Varas10/Alimentation-Photovoltaique/Rapport par fonction/Document de MAINTENANCE.md

# 1. Introduction

Ce document décrit les procédures de maintenance pour le système d'alimentation photovoltaïque développé dans le cadre du projet. Il vise à assurer le bon fonctionnement du système sur le long terme en proposant des recommandations d'entretien, des procédures de diagnostic et des solutions aux problèmes courants.

# 2. Description du système

Le système est conçu pour convertir l'énergie solaire en électricité utilisable. Il comprend :

- Un panneau photovoltaïque (PV) pour la capture de l’énergie solaire.
    
- Un convertisseur pour adapter la tension.
    
- Un système de stockage (batteries).
    
- Un circuit de régulation et de protection.
    
- Un dispositif de mesure et de contrôle.

# 3. Procédures de maintenance

### 3.1. Inspection régulière

- Vérifier visuellement l’état du panneau PV (absence de fissures, propreté).
    
- Examiner les connexions électriques (absence d’oxydation, solidité des connexions).
    
- Contrôler l’état des câbles et des connecteurs (usure, détérioration).
    
- Vérifier l’état des batteries (tension correcte, absence de fuites).
    
- Inspecter le convertisseur et les régulateurs de tension (échauffement anormal, composants endommagés).

### 3.2. Nettoyage

- Nettoyer les panneaux PV avec un chiffon humide non abrasif pour éviter l’accumulation de poussière.
    
- Enlever les débris autour du système pour éviter toute obstruction.
    
- Dépoussiérer les composants électroniques avec un souffleur d’air sec.

### 3.3. Tests périodiques

- Mesurer la tension et le courant de sortie des panneaux PV.
    
- Vérifier les niveaux de charge des batteries.
    
- Tester le bon fonctionnement des convertisseurs et régulateurs.

# 4. Dépannage et erreurs courantes

|Problème|Cause possible|Solution|
|---|---|---|
|Faible production d’énergie|Panneau sale ou endommagé|Nettoyer ou remplacer le panneau|
|Batterie ne charge pas|Connexion lâche, batterie défectueuse|Vérifier les connexions, tester ou remplacer la batterie|
|Convertisseur chauffe anormalement|Ventilation insuffisante, surcharge|Vérifier la charge, améliorer la ventilation|
|Absence de sortie électrique|Problème de connexion, fusible grillé|Inspecter et remplacer le fusible si nécessaire|

# 5. Pièces de rechange et consommables

- Fusibles de rechange
    
- Connecteurs et câbles électriques
    
- Batteries de remplacement
    
- Produits de nettoyage pour panneaux PV

# 6. Sécurité

- Couper l’alimentation avant toute intervention sur le système.
    
- Utiliser des équipements de protection individuelle (gants isolants, lunettes de protection).
    
- Éviter d’intervenir en milieu humide ou sous la pluie.
    
- Suivre les consignes du fabricant pour la manipulation des batteries.
