Varas10/Alimentation-Photovoltaique/Rapport par fonction/Documents de MISE EN SERVICE.md

TALENT Julien & RUIZ Evan

# Matériels nécessaires
--- 
### Câbles :
- 5 câbles bananes

### Cartes :
- Cartes routée regroupant la partie commande et l'alimentation de la partie commande.
- Carte de la partie puissance.

### Multimètre

# Branchement
---
- Branchez le - du panneau photovoltaïque (PV) sur la borne PV- de la carte de commande.
- Branchez le + du PV sur la borne PV+ de la carte commande.
- Branchez le connecteur "Alim-" sur l'une des bornes M du Hacheur (partie puissance).
- Branchez le connecteur "Alim+" sur la borne F du Hacheur.
- Brancher le + du PV sur la borne A du Hacheur.
- Branchez le multimètre sur la sortie du Hacheur.

# Réglages 
---
### Tension de sortie
- Réglez la tension de sortie en tournant le potentiomètre.
- Pour alimenter un téléphone, réglez la tension de sortie du Hacheur à 5V.
- Pour alimenter une carte Altéra, réglez la tension de sortie du Hacheur à 7,5V.

#### Mise en garde
- Attention à ne pas trop dépasser le 7,5V au risque de faire chauffer les composants ainsi que le téléphone si il est branché à ce moment là.

# Bon fonctionnement du système
---

- Si la tension de sortie est adaptée à vos besoins (5V ou 7,5V) alors le montage fonctionne très bien.
