Varas10/Alimentation-Photovoltaique/Rapport par fonction/rapport perso de julien.md

Talent Julien
# Rapport final du projet d'alimentation hacheur

## 1. Introduction

L’objectif de ce projet était de concevoir une alimentation à découpage alimentée par un panneau photovoltaïque (PV) de **20V - 10W**, capable de fournir :

- **5V - 1A** pour un téléphone,
    
- **7,5V - 0,8A** pour une carte Altera DE1.

Pour mener à bien ce projet, nous avons utilisé **Micro-Cap** pour les simulations et **Eagle** pour le routage de la carte de commande. Une carte hacheur nous a été fournie, et nous avons conçu une carte additionnelle utilisant un **NE555** pour générer le signal de commande du hacheur.

## 2. Déroulement du projet

Le projet s'est déroulé conformément au plan initial. Nous avons adopté une approche modulaire, ce qui nous a permis d’aborder chaque étape de manière organisée :

1. **Étude du fonctionnement d’un hacheur et de la modulation PWM.**
    
2. **Simulation du circuit sous Micro-Cap** pour vérifier les performances théoriques.
    
3. **Conception et routage de la carte de commande sous Eagle.**
    
4. **Fabrication et test du circuit final** avec la carte hacheur.

## 3. Résultats et analyse

Les résultats finaux **correspondent aux attentes**. Nous avons réussi à obtenir les tensions de sortie prévues en ajustant le rapport cyclique du signal PWM. Cependant, un problème notable a été identifié :

- Le système conçu **n’est pas pratique pour un utilisateur lambda**, car il nécessite de **mesurer la tension de sortie avec un multimètre** et d’ajuster le rapport cyclique via un potentiomètre.

## 4. Bilan personnel et perspectives d’amélioration

### **Intérêt du projet**

Ce projet a été **très intéressant**, car il m’a permis de découvrir le fonctionnement d’une alimentation à découpage et de **concevoir un oscillateur**.

### **Apports techniques et personnels**

J’ai gagné en autonomie pour la réalisation de futurs projets et je me sens **plus confiant dans ma capacité à mener un projet à bien**.

### **Améliorations possibles**

Si je devais refaire ce projet, je prendrais plus de temps pour réfléchir aux **tolérances des composants** à prendre en compte.

Pour améliorer le système, il serait intéressant de :

- **Intégrer toute l’électronique sur une seule carte** pour plus de compacité.
    
- **Automatiser la régulation de la tension** afin d’éviter l’ajustement manuel.
    
- **Ajouter un interrupteur de sélection** pour choisir l’appareil à alimenter (téléphone ou carte Altera DE1) sans besoin de réglage manuel.

## 5. Conclusion

Ce projet a été une **expérience enrichissante** tant sur le plan technique que personnel. Il m’a permis de mettre en application des notions théoriques et d’améliorer ma méthodologie de travail. Avec quelques améliorations, cette alimentation pourrait être plus ergonomique et accessible à un utilisateur non expérimenté.
