Varas10/Alimentation-Photovoltaique/Rapport par fonction/F2 - Partie commande/Rapport partie commande.pdf

# Rapport partie commande

TALENT Julien et RUIZ Evan

# Rôle de la fonction :

Elle permet de choisir la tension de sortie en modulant la largeur de l'impulsion (la pwm).

# Schéma :

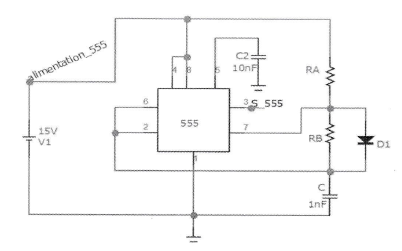
[picture p5: figure]

Sans le potentiomètre

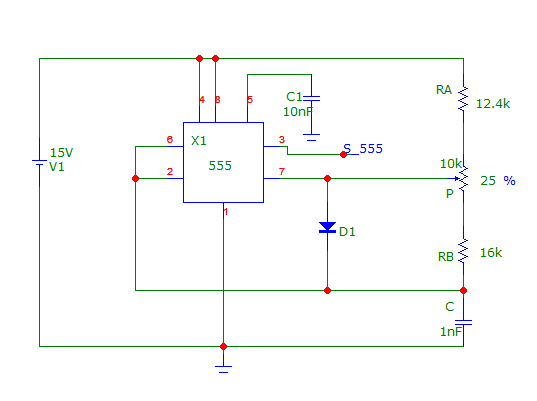
[picture p6: figure]

avec le potentiomètre

# Fonctionnement :

Grâce au potentiomètre on peut modifier la largeur des impulsion ce qui permet de modifier le rapport cyclique.

La diode fait passer le courant jusqu'au condensateur lorsqu'il est en charge.

En charge le courant passe par RA et la diode, et en décharge il passe par RB et va dans le 555

# Choix des résistances :

Afin de choisir les résistances adéquats, nous avons procédé a une série de calculs :

Appareil à alimenter avec tension panneau = Ve = 20V | Pour le téléphone (5V) : | Pour la carte altéra (7.5V) :
Tension à la sortie du hacheur : | 5V | 7.5V

Appareil à alimenter avec tension panneau = Ve = 20V | Pour le téléphone (5V) : | Pour la carte altéra (7.5V) :
rapport cyclique : α = V s V e | 15 = 25% 5 = | = 7.5 15 = 38%
période d'oscillation T = 1 f | = 40k = 25µs 1
temps à l'état hautt1 = α ∗ T | = 0.25 ∗ 25 −6 = 6.25µs | = 0.38 ∗ 25 −6 = 9.5µs
0.693∗C t1 Ra = | = 0.693∗1⁻⁹ = 9kΩ 6.25 −6 | = 9.5 −6 0.693∗1⁻⁹ = 13.7kΩ
t2 = (1 − α) ∗ T | −6 = 18.75µs = (1 − 0.25) ∗ 25 | = (1 − 0.38) ∗ 25 −6 = 15.5µs
t2 RB = 0.693∗c − P | = 27kΩ | = 22.4kΩ
RA+RB | = 36kΩ | = 36kΩ

## Simulation avec RA et RB :

| RA normalisée | Rb normalisée | rapport cyclique que l'on devrait obtenir | rapport cyclique vaec la simulation
Vs = 5V | 8.2kΩ | 27kΩ | 23% | 25%
VS = 7.5V | 15kΩ | 22kΩ | 41% | 43%

On constate que la simulation est proche du résultats que l'on attendait.

# Ajout d'un potentiomètre :

évolution de la tensions par rapport à l'ensolellement | il faut malgré tout avoir une tension en sortie du hacheur VS de : | rapport cyclique correspondant | position du potentiomètre
descend à 16V | 7.5V | maximal de 47% | basse (x=100%)
monte à 22V | 5V | minimal de 23% | haute (x=0)

## calcul de RA et Rb

On utilise la formule suivante :

RA = 6.4kΩ , valeur normalisée : 6.8kΩ RB = 17kΩ , valeur normalisée : 18kΩ

## Simulation :

pour V1=16v ou pour V1=22V, les rapports cyclique et tensions de sortie sont identique.

Position du Potentiometre | rapport cyclique prévue | rapport cyclique obtenue | fréquence d'oscillation observée
Haute(x=0) | 19.5% | 21% | 40,2kHz
Basse (x=100%) | 48% | 50% | 39,5kHz

# Mesures et chronogrammes

## Problème !

Notre coupe RA-RB nous empêchez de descendre en dessous de 26% de rapport cyclique or on souhaite définir un rapport cyclique de 20% donc on change les résistances.

On obtient

## P en position basse(Potentiomètre à 100%) :

En position basse, le rapport cyclique doit être maximal

## calculs :

RA =

αmin∗P

αmax−αmin
RB =

RA−αmin(RA+P)

αmin
obtenue à partir de la formule du rapport cyclique pour X=0 :

α =

RA
Ra+RB+P
avec

RA + RB + P = RA+P

αmax

pour X=0 et

RA + RB + P =

RA

αmin

pour x=1.

RA =4.3kΩ et RB = 14kΩ.
On utiliseras des résistances normalisées E12 : RA = 3.9kΩ et Rb = 15kΩ.

tension VC | la tension de sortie Vs est à l'état | formule (p=10k) | rapport cyclique (pratique) : | Rapport cyclique (théorie) :
monte | haut pendant 11.4µs | t1 = 0.693(RA + P)C = 9.6µs | 51% | 48%
descend | bas pendant 10.8µs | t2 = 0.693RB ∗ C = 10.3µs

## P en position haute(Potentiomètre à 0%) :

En position haute, le rapport cyclique doit être le minimum voulu :

## calculs :

tension VC | la tension de sortie Vs est à l'état | formule (p=10k) | rapport cyclique (pratique) : | Rapport cyclique (théorie) :
monte | haut pendant 44µs | t1 = 0.693(RA + P)C = 2.7µs | 19.6% | 13.5%
descend | bas pendant 16.4µs | t2 = 0.693RB ∗ C = 17.3µs

# Conclusion :

Donc nous avons assemblé la partie commande :

Grâce à la PWM, on peut adapté le rapport cyclique par rapport à nos besoins(20% - > 50%).
De plus, les résistances choisis sont calculer pour obtenir une tension de sortie adéquate. Alors on peut alimenter une carte Altera en 7.5V ou un téléphone portable en 5V.
