Varas10/Alimentation-Photovoltaique/20250318_163907.jpg

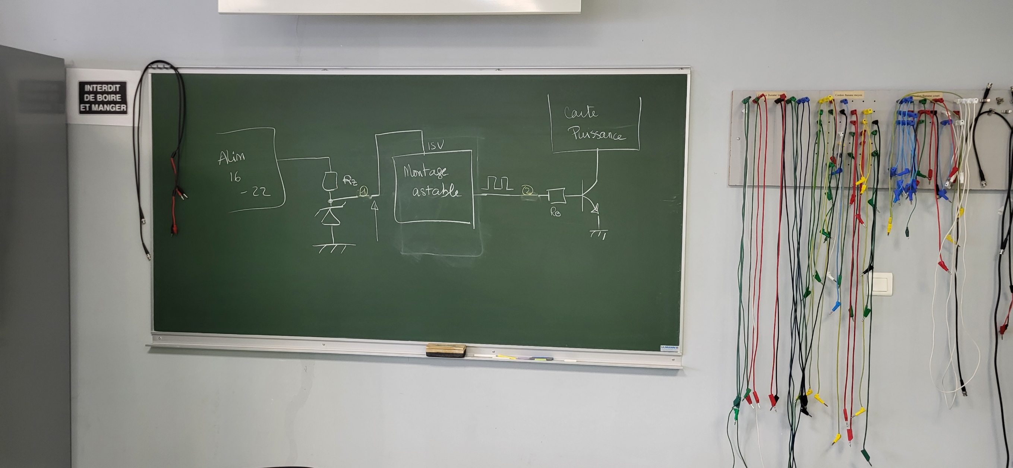
20250318_163907.jpg
