Varas10/Alimentation-Photovoltaique/Rapport par fonction/F1 - Partie puissance/Courbes hacheur.png

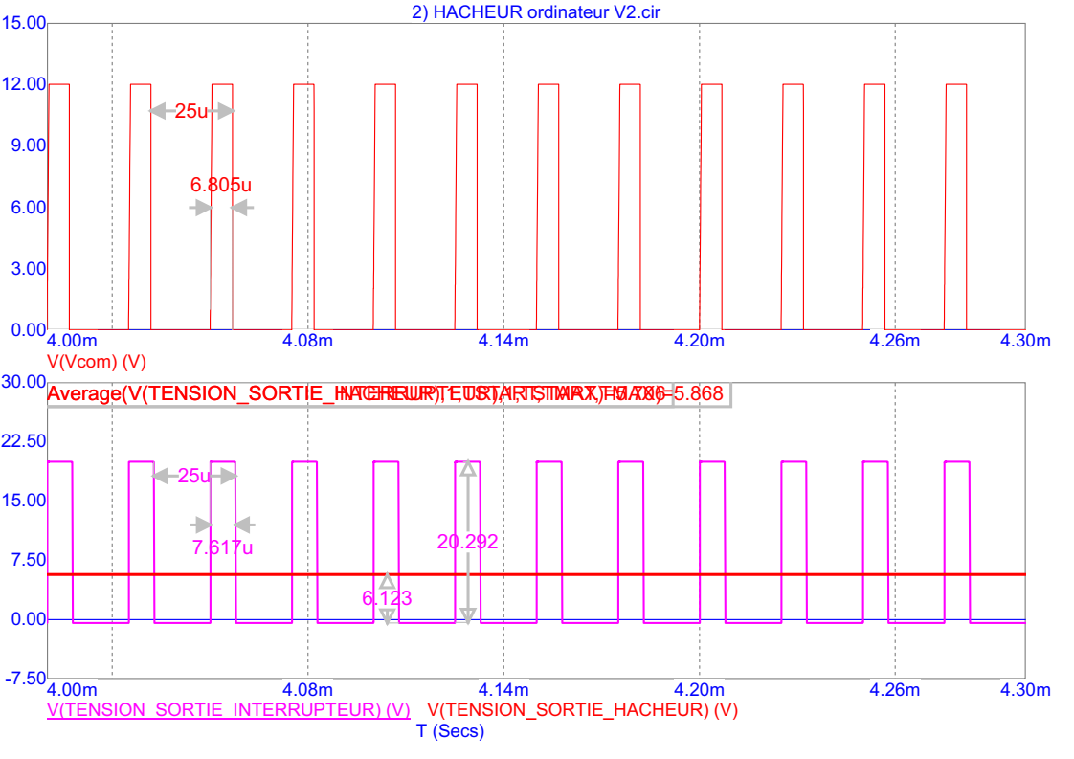
Rapport par fonction/F1 - Partie puissance/Courbes hacheur.png
