Varas10/Alimentation-Photovoltaique/Rapport par fonction/F1 - Partie puissance/montage hacheur.png

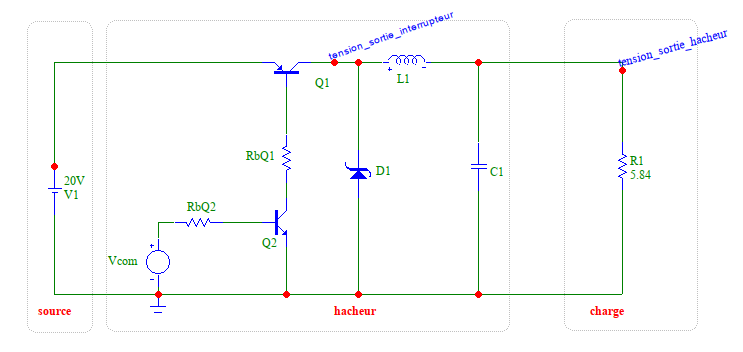
Rapport par fonction/F1 - Partie puissance/montage hacheur.png
