Varas10/Alimentation-Photovoltaique/Rapport par fonction/Montage global/Cahier des charges images du système.png

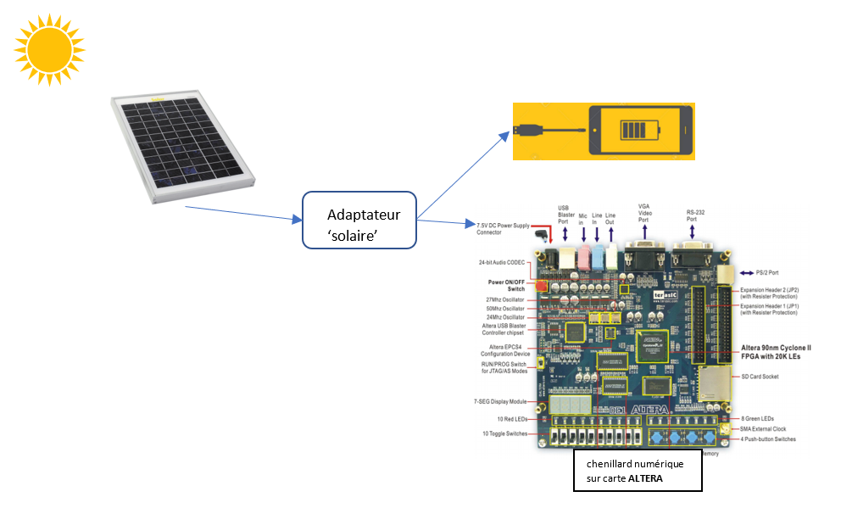
Rapport par fonction/Montage global/Cahier des charges images du système.png
