Varas10/Alimentation-Photovoltaique/Rapport par fonction/Montage global/Routage .png

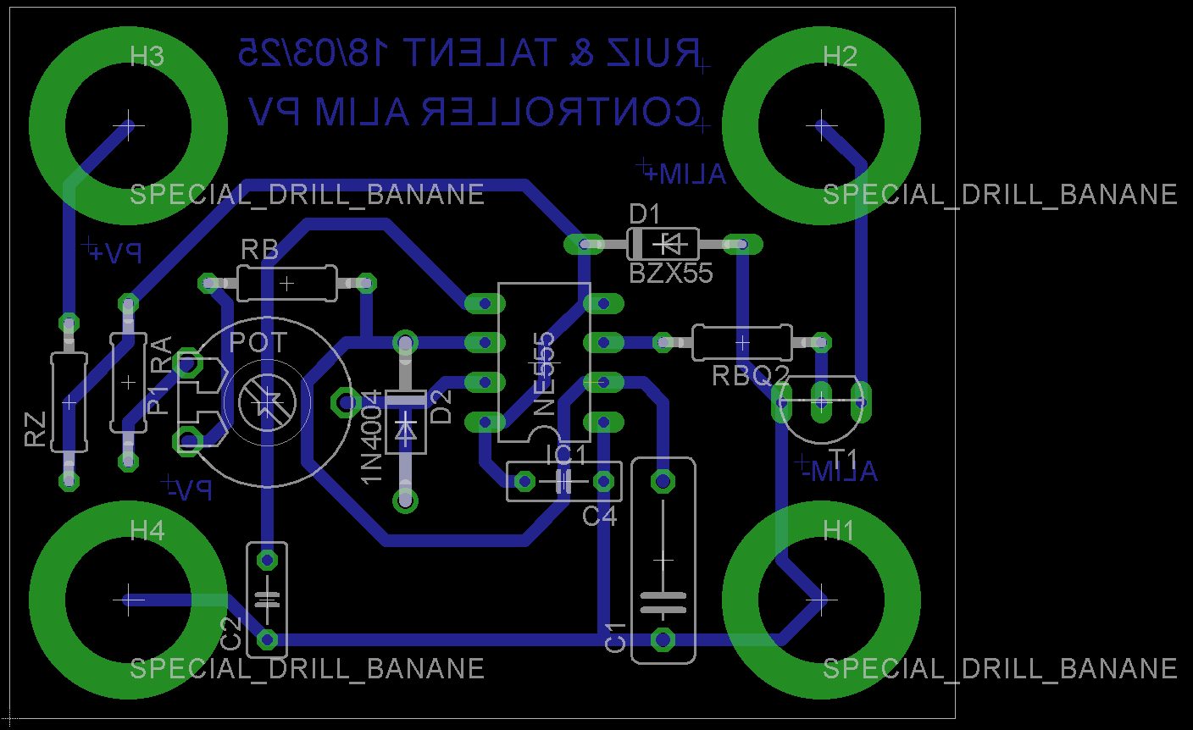
Rapport par fonction/Montage global/Routage .png
