Varas10/Alimentation-Photovoltaique/Rapport par fonction/Montage global/Schéma Eagle montage final.png

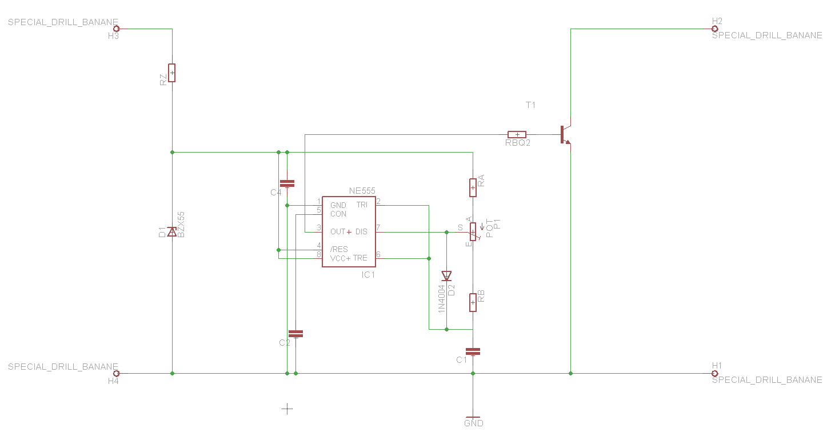
Rapport par fonction/Montage global/Schéma Eagle montage final.png
