Varas10/Alimentation-Photovoltaique/Rapport par fonction/Montage global/Schéma fonctionelle.png

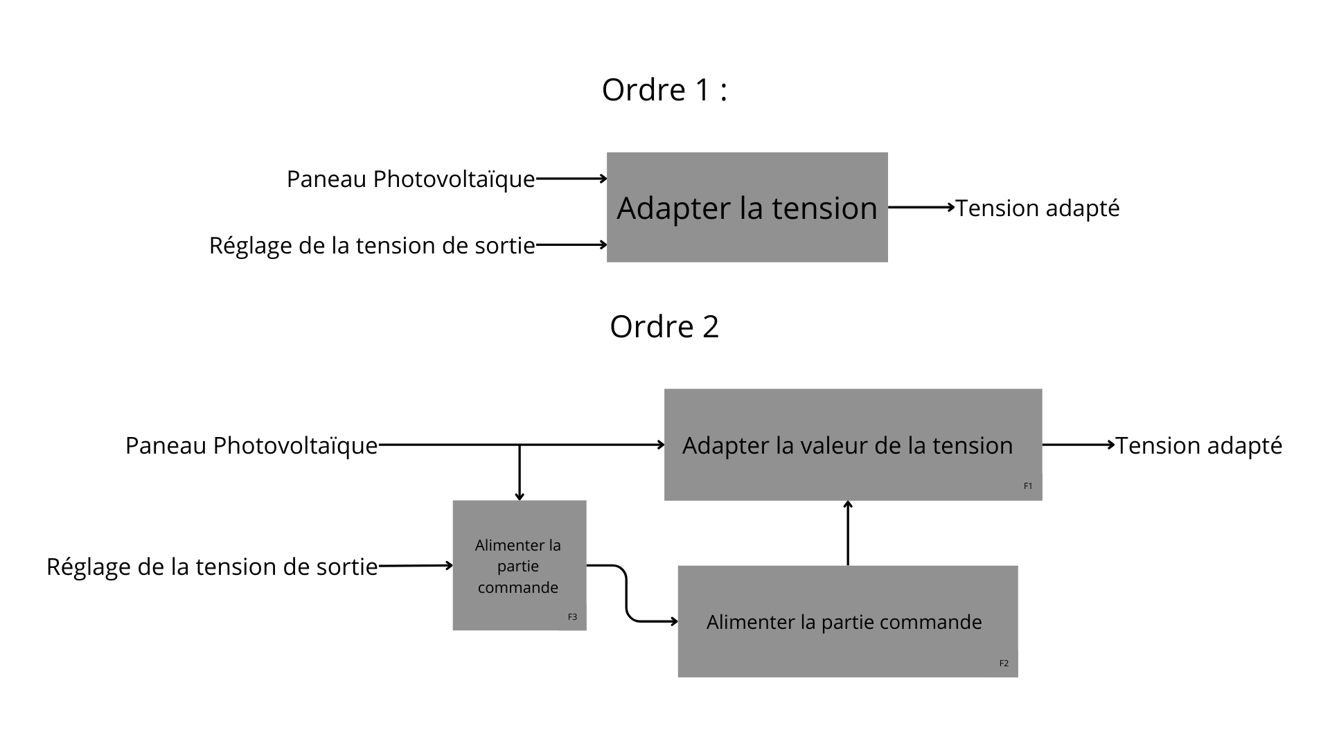
Rapport par fonction/Montage global/Schéma fonctionelle.png
