Varas10/Alimentation-Photovoltaique/Schéma Spice/HACHEUR ordinateur V1 .cir

[Main]
FileType=CIR
Version=12.00
Program=Micro-Cap
Component Version=10.00
Shape Version=11.00
Screen=1920,1080
MCAPVersion=12.2.0.3
Key ID=Demo
NLCnt=41
TXCnt=7

[shapedef]
Name=Battery
Line=0,0,22,0
Line=22,-3,22,3
Line=26,-7,26,7
Line=26,0,48,0
Current=32,8,16,8

[shapedef]
Name=Capacitor
Line=0,0,22,0
Line=22,-8,22,8
Line=26,-8,26,8
Line=26,0,48,0
Current=32,12,16,12

[shapedef]
Name=Diode
Root="Diode.root",0,0,0

[shapedef]
Name=Diode.root
Line=0,0,20,0
Line=28,0,48,0
Rectangle=18,-8,20,8
PolyClosed=3
PolyLine=20,0
PolyLine=28,-8
PolyLine=28,8
Current=32,16,16,16

[shapedef]
Name=DNMOS
Root="Mos2.root",0,0,0
Line=14,0,24,0
PolyClosed=3
PolyLine=17,0
PolyLine=20,-3
PolyLine=20,3

[shapedef]
Name=Ground
Line=0,0,12,0
Line=12,-8,12,8
Line=18,-4,18,4
Line=24,0,24,0

[shapedef]
Name=Inductor
Line=42,0,48,0
Line=0,0,5,0
Arc=5,-7,17,7 , 11,-7,5,0
Arc=13,-7,25,7 , 19,-7,13,0
Arc=29,-7,41,7 , 35,-7,29,0
Arc=21,-7,33,7 , 27,-7,21,0
Arc=6,-7,18,7 , 18,0,12,-7
Arc=14,-7,26,7 , 26,0,20,-7
Arc=22,-7,34,7 , 34,0,28,-7
Arc=30,-7,42,7 , 42,0,36,-7
Line=11,-7,12,-7
Line=19,-7,20,-7
Line=27,-7,28,-7
Line=35,-7,36,-7
Arc=13,-4,17,2 , 13,-1,15,2
Arc=29,-4,33,2 , 29,-1,31,2
Arc=21,-4,25,2 , 21,-1,23,2
Arc=14,-4,18,2 , 16,2,18,-1
Arc=30,-4,34,2 , 32,2,34,-1
Arc=22,-4,26,2 , 24,2,26,-1
Line=15,2,16,2
Line=23,2,24,2
Line=31,2,32,2
Line=5,5,9,5
Line=41,5,41,9
Line=39,7,43,7
Current=32,8,16,8

[shapedef]
Name=Mos2.root
Line=0,8,10,8
Line=10,-8,10,8
Line=14,-11,14,-5
Line=14,-3,14,3
Line=14,5,14,11
Line=14,-8,24,-8
Line=14,8,24,8
Line=24,0,24,24
Line=24,-8,24,-24
Current=32,-24,32,-16
Current=32,24,32,16
Current=0,0,8,0

[shapedef]
Name=Plus.root
Line=-2,0,2,0
Line=0,-2,0,2

[shapedef]
Name=Resistor
PolyOpen=12
PolyLine=0,0
PolyLine=0,0
PolyLine=12,0
PolyLine=14,-4
PolyLine=18,4
PolyLine=22,-4
PolyLine=26,4
PolyLine=30,-4
PolyLine=34,4
PolyLine=36,0
PolyLine=48,0
PolyLine=48,0
Current=32,8,16,8

[shapedef]
Name=SPICE_V
Root="Vsource.root",0,0,0

[shapedef]
Name=Vsource.root
Line=0,0,12,0
Line=36,0,48,0
Ellipse=12,-12,36,12
FColor=None
Line=7,5,7,9
Root="Plus.root",41,7,0
Current=32,16,16,16

[compdef]
Name=Ground
Definition=Ground
Shape=Ground
Mask=1793
Used=266
memo=Ground
Label Offset=0,0,0,0
PinCnt=1
Pin="PinA",0,0,-3,-7

[compdef]
Name=Battery
Definition=Battery
Shape=Battery
Mask=6913
Used=57
memo=Battery
Label Offset=19,7,10,13
PinCnt=2
Pin="Plus",6,0,-4,-5
Pin="Minus",0,0,-10,-5

[compdef]
Name=Voltage Source
Definition=VSpice
Shape=SPICE_V
Mask=4865
Used=38
memo=Voltage Source
Label Offset=19,13,15,13
PinCnt=2
Pin="Plus",6,0,-5,-6
Pin="Minus",0,0,-20,-6

[compdef]
Name=Inductor
Definition=Inductor
Shape=Inductor
Mask=7681
Used=29
memo=Inductor
Label Offset=18,9,11,12
PinCnt=2
Pin="Plus",6,0,-5,-9
Pin="Minus",0,0,-3,-9

[compdef]
Name=Resistor
Definition=Resistor
Shape=Resistor
Mask=6913
Used=165
memo=Resistor
Label Offset=18,6,8,11
PinCnt=2
Pin="Plus",6,0,-10,-4
Pin="Minus",0,0,-14,-4

[compdef]
Name=Capacitor
Definition=Capacitor
Shape=Capacitor
Mask=7425
Used=27
memo=Capacitor
Label Offset=16,12,12,12
PinCnt=2
Pin="Plus",6,0,-3,-5
Pin="Minus",0,0,-14,-5

[compdef]
Name=IRF151
Definition=NMOS
Shape=DNMOS
Mask=4224
memo=N-Channel Power MOSFET Vdss=60V Id=40A Rds=0.055ohm
Label Offset=29,-13,-5,26
PinCnt=4
Pin="Drain",3,-3,7,8
Pin="Gate",0,1,-19,-2
Pin="Source",3,3,6,12
Pin="Body",3,3,6,0
Power=150

[compdef]
Name=UTX4105
Definition=Diode
Shape=Diode
Mask=4224
memo=Super Fast Recovery Rectifier Vr=50V If=4A
Label Offset=18,10,12,12
PinCnt=2
Pin="Anode",6,0,-13,-8
Pin="Cathode",0,0,-27,-8

[Circuit]
Window Placement=2,3, -1,-1, -8,-31, 234,234,1689,802
Default Object=Color=#C0C0C0,Width=3
Default Object Font=Height=-21,FStyle=0,Color=#FF0000,Name=Arial
Default Object Apply Border To Text=No
Default Object Apply Fill To Text=No
Default Object GridSnap=No
NodeVoltageFormat=3
CurrentFormat=3
PowerFormat=3
PathDelayFormat=3
WarningFormat=3
GridTextFormulaFormat=3
Window Placement in Transient Analysis=0,1, -1,-1, -8,-31, 633,0,1266,528
Window Placement in DC Probe=0,1, -1,-1, -8,-31, 633,0,1266,555
SpiceType=AMBIGUOUS
Title_Block_Border=None
Title_Block=False
Show Nodes=False
Show Voltages=True
Show Current=False
Show Power=False
Show Condition=False
Show Pin Connections=False
Show Connection Warnings=False
Show Cross=False
Show Attribute Text=True
Show Grid Text=True

[Object]
Object=Rectangle
Rounded=True
CBorder=#C0C0C0
Pattern=Dot
Px=1007,324,1071,634

[Comp]
Name=Ground
Px=1032,608
Rot=7

[Wire]
Pxs=1296,496,1296,592

[Wire]
Pxs=1560,368,1560,440

[Wire]
Pxs=1560,488,1560,592

[Wire]
Pxs=1296,360,1320,360

[Wire]
Pxs=1224,360,1256,360

[Comp]
Name=Battery
Px=1032,512
Rot=5
COff=7,1042,471,0,-14

[Attr]
ON=10,-27,PART
V=V1
Style=8192

[Attr]
ON=10,-41,VALUE
V=35V
Style=8192

[Attr]
ON=0,0,PACKAGE
V

[Wire]
Pxs=1032,512,1032,592

[Comp]
Name=Voltage Source
Px=1256,400
Rot=6

[Attr]
ON=-41,13,PART
V=Vcom
Style=8192

[Attr]
ON=15,-41,VALUE
V=DC 0 AC 1 0 Pulse 0 12 0 600n 5n 2.5u 50u

[Attr]
ON=0,0,PACKAGE
V

[Attr]
ON=0,0,Saved_None
V=DC 12V
Style=256

[Attr]
ON=0,0,SMOOTHING
V=N
Style=256

[Attr]
ON=0,0,Saved_PulseS
V=N
Style=256

[Attr]
ON=0,0,FRACTION
V=.2
Style=256

[Attr]
ON=0,0,Saved_PulseF
V=.2
Style=256

[Attr]
ON=0,0,Saved_Pulse
V=DC 0 AC 1 0 Pulse 0 12 0 600n 5n 2.5u 50u
Style=256

[Wire]
Pxs=1256,360,1272,360

[Comp]
Name=Inductor
Px=1368,360
Rot=6

[Attr]
ON=-33,9,PART
V=L1
Style=8192

[Attr]
ON=-46,23,INDUCTANCE
V=6mH

[Attr]
ON=0,0,PACKAGE
V

[Comp]
Name=Resistor
Px=1560,440
Rot=1

[Attr]
ON=8,11,PART
V=R1
Style=8192

[Attr]
ON=8,25,RESISTANCE
V=5.84
Style=8192

[Attr]
ON=0,0,PACKAGE
V

[Wire]
Pxs=1368,360,1416,360

[Comp]
Name=Capacitor
Px=1416,488
Rot=5

[Attr]
ON=12,-26,PART
V=C1
Style=8192

[Attr]
ON=12,-40,CAPACITANCE
V=100uF

[Attr]
ON=0,0,PACKAGE
V

[Wire]
Pxs=1416,360,1416,440

[Wire]
Pxs=1416,488,1416,592

[Wire]
Pxs=1032,360,1032,464

[Wire]
Pxs=1296,592,1416,592

[Wire]
Pxs=1032,360,1080,360

[Wire]
Pxs=1032,592,1144,592

[Wire]
Pxs=1032,592,1032,608

[Wire]
Pxs=1416,360,1560,360

[Wire]
Pxs=1560,360,1560,368

[Wire]
Pxs=1416,592,1560,592

[Wire]
Pxs=1272,360,1296,360

[Comp]
Name=Inductor
Px=1128,360
Rot=6

[Attr]
ON=-33,9,PART
V=L2
Style=8192

[Attr]
ON=-46,23,INDUCTANCE
V=1mH

[Attr]
ON=0,0,PACKAGE
V

[Comp]
Name=Capacitor
Px=1144,504
Rot=5

[Attr]
ON=12,-26,PART
V=C2
Style=8192

[Attr]
ON=12,-40,CAPACITANCE
V=100uF

[Attr]
ON=0,0,PACKAGE
V

[Wire]
Pxs=1144,360,1144,456

[Wire]
Pxs=1144,504,1144,592

[Wire]
Pxs=1144,592,1296,592

[Wire]
Pxs=1128,360,1144,360

[Wire]
Pxs=1144,360,1176,360

[Object]
Object=Rectangle
Rounded=True
CBorder=#C0C0C0
Pattern=Dot
Px=1082,324,1177,634

[Object]
Object=Rectangle
Rounded=True
CBorder=#C0C0C0
Pattern=Dot
Px=1187,323,1469,633

[Object]
Object=Rectangle
Rounded=True
CBorder=#C0C0C0
Pattern=Dot
Px=1487,323,1619,633

[Comp]
Name=IRF151
Px=1200,384
Rot=3

[Attr]
ON=-1,-40,PART
V=Q1
Style=8192

[Attr]
ON=29,1,MODEL
V=IRF151

[Attr]
ON=29,15,POWER
V=150

[Attr]
ON=29,43,PACKAGE
V=TO-204AE

[Wire]
Pxs=1296,360,1296,448

[Comp]
Name=UTX4105
Px=1296,448
Rot=1

[Attr]
ON=18,10,PART
V=D2
Style=8192

[Attr]
ON=18,24,MODEL
V=UTX4115

[Attr]
ON=18,52,PACKAGE
V=MSC-B

[Wire]
Pxs=1208,384,1208,400

[Wire]
Pxs=1256,360,1256,400

[Grid Text]
Text="source"
Px=1016,616
FStyle=4
Color=#FF0000
GridSnap=True
JustifyH=Left
JustifyV=Bottom
CBorder=None

[Grid Text]
Text="tension_sortie_hacheur"
Px=1560,368
Angle=11
GridSnap=True
JustifyH=Left
JustifyV=Bottom
CBorder=None

[Grid Text]
Text="tension_sortie_interrupteur"
Px=1272,360
Height=-10
Font=Arial
Angle=19
GridSnap=True
JustifyH=Left
JustifyV=Bottom
CBorder=None

[Grid Text]
Text="filtrage"
Px=1104,616
FStyle=4
Color=#FF0000
GridSnap=True
JustifyH=Left
JustifyV=Bottom
CBorder=None

[Grid Text]
Text="hacheur"
Px=1312,616
FStyle=4
Color=#FF0000
GridSnap=True
JustifyH=Left
JustifyV=Bottom
CBorder=None

[Grid Text]
Text="charge"
Px=1528,616
FStyle=4
Color=#FF0000
GridSnap=True
JustifyH=Left
JustifyV=Bottom
CBorder=None

[Grid Text]
Text="tension_continue_entree_hacheur"
Px=1032,360
Height=-10
Angle=16
GridSnap=True
JustifyH=Left
JustifyV=Bottom
CBorder=None

[Schematic]
CurrentSection 0=0
CurrentSection 1=0
CurrentSection 2=0
CurrentSection 3=0
Splitter.xs=0
Splitter.ys=0
TextQuad=4099
Scale=1
GridUser=10
ShapeGroups="Main","Euro","Polarity","Main1","Main11","Electrolytic","GroundArrow","DeMorgan"
CalcRMS=False
CalcAVG=False
CalcPeak=False
CalcVoltage=True
DisplayMeasure=Last
ShareScales=True

[Tools]
Pos=Top
FILESAVEASOLD=No
BOM=No
FILEPCB=No
PROBE=Yes
SELECT=Yes
PAN=Yes
COMP=Yes
TEXT=Yes
WIRE=Yes
WIRED=Yes
BUS=Yes
GRAPHIC=Yes
FLOWCHART=Yes
LINE=No
ELLIPSE=No
RECT=No
DIAM=No
ARC=No
PIE=No
TRIANGLE=No
STAR=No
LEFTBRK=No
RIGHTBRK=No
BOTHBRK=No
META=No
PARALLELOGRAM=No
FC_PROCESS=No
FC_ALT_PROCESS=No
FC_DECISION=No
FC_DATA=No
FC_PREDEFPROCESS=No
FC_INTERNALSTORAGE=No
FC_DOCUMENT=No
FC_MULTIDOCUMENT=No
FC_TERMINATOR=No
FC_PREPARATION=No
FC_MANUALINPUT=No
FC_MANUALOPERATION=No
FC_CONNECTOR=No
FC_OFFPAGECONNECTOR=No
FC_PUNCHCARD=No
FC_PUNCHEDTAPE=No
FC_SUMMING_JUNCTION=No
FC_OR=No
FC_COLLATE=No
FC_SORT=No
FC_EXTRACT=No
FC_MERGE=No
FC_STORED_DATA=No
FC_DELAY=No
FC_SAS=No
FC_MAGNETIC_DISK=No
FC_DAS=No
FC_DISPLAY=No
SPREAD_SHEET=Yes
POLYCLOS=No
POLYOPEN=No
FLAG=Yes
INFO=Yes
HELP=Yes
HELP_SPICE=No
LINK=Yes
CHECK=Yes
REGION_ENABLE=Yes
TITLE_BLOCK=Yes
DIGTRC=No
DIGTRC2=No
BUILD_COMMAND=Yes
DIGALL=No
GRIDTEXT=Yes
COMPTEXT=Yes
NODE=Yes
MEASURED=Yes
NODEV=Yes
CURRENT=Yes
POWER=Yes
CONDITIN=Yes
PIN=Yes
CONNWARN=Yes
CROSS=No
GRID=Yes
BORDER=Yes
BORDERONE=Yes
TITLE=Yes
RUBBER=Yes
PROPERTY=Yes
STEP=Yes
MIRROR=Yes
ROTATE=Yes
FLIPY=Yes
FLIPX=Yes
CIR_MAKEMACRO=No
CLEARCUTWIRE=No
CLIPBOARDCIRPAGE2BMM=No
FINDCOMP=Yes
FIND=Yes
REPEAT=No
REPLACE=No
MODEL=Yes
CIR2CKT=No
ATTDISP=No
ENABLE=Yes
DISABLE=Yes
ENABLE_WITH=Yes
TOFRONT=Yes
TOBACK=Yes
SELNEXT=No
PAGEADD=No
PAGEADDTEXT=No
ADDSECTION=No
PAGEDEL=No
ZOOMIN=Yes
ZOOMOUT=Yes
AUTOSCALECIR=Yes
GOTOFLAG=No
UPLEVEL=Yes
COLOR=Yes
FONT=Yes
STYLE=Yes
DM_LAST=No
DM_RMS=No
DM_AVG=No
DM_PEAK=No
GRID_NONE=No
GRID_NORMAL=No
GRID_BOLD_5=No
GRID_BOLD_6=No
GRID_BOLD_USER=No
GRAPH_PAPER=No
SPLITCIRTEXTH=No
SPLITCIRTEXTV=No
SPACE_SPLITTERS_EVENLY=No
NORMALCIR=No
RENAMEDEFINE=No
RENAMECMP=No
ATTALIGN=No
RESETNODEPOS=No
FIT2STANDARD=No
NODESNAP=No
MOVETEXT=No
TEXTINC=No
TOGGLETEXT=No
TOGGLEMODE=No
TOLERANCE=No
ALIGNAB=No
ALIGNLEFT=No
ALIGNCENTER=No
ALIGNRIGHT=No
ALIGNTOP=No
ALIGNMIDDLES=No
ALIGNBOTTOM=No

[Section]
Index=0
Name="HACHEUR ordinateur V1 "
Type=Main
Enable=True
CurrentPage 0=0
CurrentPage 1=0
CurrentPage 2=0
CurrentPage 3=0
TabSize 0=425
TabSize 1=425
TabSize 2=425
TabSize 3=425

[Page]
Index=0
Section=0
Print=True
Enable=True
Name=Main
PrinterScale=1
Scale 0=1
Scale 1=1
Scale 2=1
SB 3=306,81
Scale 3=1
Px=970,621
WinBackGround Color=#FFFFFF
Select Color=#FF0000
Anchor Color=#000000
Select Box Color=#000080
Grid Text Color=Height=-12,FStyle=0,Color=#0000FF,Name=Verdana
Grid Text RTF=False
Grid Text Angle=0
Grid Text GridSnap=True
Grid Text PinIt=False
Grid Text JustifyH=Left
Grid Text JustifyV=Bottom
Grid GradientColor2=None
Grid OutlineThickness=1
Grid OutlineColor=None
Component Color=#0000FF
Attribute Text=Height=-12,FStyle=0,Color=#008000,Name=Verdana
Wire Color=#008000
Bus Color=#008000
Pin Connection=Height=-10,FStyle=0,Color=#FF0000,Name=Arial
Pin Marker Color=#008000
Node Number=Height=-11,FStyle=0,Color=#FF00FF,Name=Arial
Node Voltage Color=Height=-11,FStyle=0,Color=#000000,Name=Arial
Dynamic AC Voltage Color=#E4E4E4
Text Banner Text=Height=-15,FStyle=0,Color=#800000,Name=Arial
Title Block Background=#C0C0C0
Current=Height=-11,FStyle=0,Color=#0000FF,Name=Arial
Power/Condition=Height=-11,FStyle=0,Color=#FF0000,Name=Arial
Digital Path Color=#FF0000
Title Block Border=#000000
Disabled	Color=#C0C0C0
Search Color=#FFFF00
Grid Color=#000000
Graph Paper=#E4E4E4
Digital 0 Color=#000000
Digital R Color=#FFFF00
Digital F Color=#FFFF00
Digital 1 Color=#FF0000
Digital X Color=#C0C0C0
Digital Z Color=#808080
Block Select Color=#51F998

[Page]
Index=1
Section=0
Type=Text
Print=False
Enable=True
Name=Text
Font=Height=-15,FStyle=0,Color=#000000,Name=Courier New
Comment Color=#008000
WinBackGround Color=#FFFFFF
Disabled	Color=#C0C0C0
KeyWord Color=#0000FF
Error	Color=#FF0000
Search Color=#FFFF00

[Page]
Index=2
Section=0
Type=Text
Print=False
Enable=True
Name=Models
Font=Height=-15,FStyle=0,Color=#000000,Name=Courier New
Comment Color=#008000
WinBackGround Color=#FFFFFF
Disabled	Color=#C0C0C0
KeyWord Color=#0000FF
Error	Color=#FF0000
Search Color=#FFFF00

[Page]
Index=3
Section=0
Type=Info
Print=False
Enable=True
Name=Info
Font=Height=-15,FStyle=0,Color=#000000,Name=Courier New
Comment Color=#008000
WinBackGround Color=#FFFFFF
Disabled	Color=#C0C0C0
KeyWord Color=#0000FF
Error	Color=#FF0000
Search Color=#FFFF00

[Text Area]
Section=0
Page=1
Text=.OPTIONS ITL4=50

[Text Area]
Section=0
Page=2
Text=* Schematic File
Text=*
Text=* Syntax:
Text=* .MODEL <model name> [AKO:<reference model name>] <ModelType>
Text=* +([<parameter name>=<value>][LOT[/#][/GAUSS|/UNIFORM|/WCASE]=[<tol>[%]] |[-<low>%,<high>%]][DEV[/#][/GAUSS|/UNIFORM|/WCASE]=[<tol>[%]]...)
Text=* ModelType must be one of OPA,D,NPN,NMOS,NJF,PUL,SIN,TRN,CORE,GASFET,VSWITCH,ISWITCH,CAP,IND,RES,PNP,PMOS,PJF,DOUTPUT,DINPUT,UADC,UDAC,UGATE,UTGATE,UEFF,UGFF,UDLY,UPLD,UROM,URAM,UBGT,UIO,LPNP,NIGBT,I,V
Text=*
Text=*Examples:
Text=* .MODEL 2N2222A NPN(BF=150 IS=1E-14)
Text=* .model M1 NMOS(KP=2.5E-5 VTO=1.345 CGDO=14.67p CGBO=4.566p)
Text=* .MODEL DK D(IS=1E-18)
Text=* .model 2N2222A AKO:2N2222 NPN (BF=55 ISE=10F)
Text=* .Model BJT1 NPN (RE=12 LOT/1/GAUSS=30% DEV/2/UNIFORM=2%)
Text=*
Text=* A .cir file is typically found in the data directory
Text=*
Text=*** From file C:\MICROCAP12\library\DIODE.LIB
Text=.MODEL 1N5818 D (BV=30 CJO=189.908P EG=690M IS=6.321U M=1.122 N=1.096 RL=82.17K
Text=+ RS=82.062M VJ=6.591 XTI=2)
Text=*** From file C:\MICROCAP12\library\ON_SEMI.LIB
Text=.MODEL D1N5818 D (BV=30 CJO=1.98376E-10 EG=0.6 FC=0.5 IBV=0.001 IS=4.4214E-05
Text=+ M=0.54046 N=1.37435 RS=0.0531374 TT=2.6273E-08 VJ=1.5 XTI=0.5)
Text=*** From file C:\MICROCAP12\library\MPBJT.LIB
Text=.MODEL BD438 PNP (BF=199.897470519053 BR=2.311252534715M CJC=5P CJE=2P
Text=+ IKF=961.730471920089M IKR=259.405608629579 IS=22.759427439152F
Text=+ ISC=99.999165441671P ISE=1.093724509278P ITF=1.37080601442M MJC=500M MJE=500M
Text=+ NC=2.000000003546 NE=1.267647717104 NF=813.06884419425M RE=162.408123282948M
Text=+ TF=106.956878243047N TR=10N VAF=100 VTF=10.000005927852 XTF=499.996440584019M)
Text=*** From file C:\MICROCAP12\library\MPBJT.LIB
Text=.MODEL BD136 PNP (BF=199.996209903524 BR=99.671345772217M CJC=5P CJE=2P
Text=+ IKF=559.818760296133M IKR=999.999675660315M IS=9.999956070726F
Text=+ ISC=404.194992780472F ISE=972.249942004551F ITF=10M MJC=500M MJE=500M
Text=+ NC=2.000000001175 NE=1.562677837831 NF=1.001625491959 RC=309.205194321893M
Text=+ RE=365.688938169078M TF=1N TR=10N VAF=100 VTF=10 XTF=500M)
Text=*** From file C:\MICROCAP12\library\ON_SEMI.LIB
Text=.MODEL D1N5822 D (CJO=1.032N FC=.5 IKF=2.37 IS=8.425U ISR=9.599U M=.6736
Text=+ RS=34.63M VJ=.75 XTI=0)
Text=*** From file C:\MICROCAP12\library\MICROSEM.LBR
Text=*** 4Amp Super Fast Recovery Rectifier
Text=.MODEL UTX4105 D (BV=50 CJO=77.0247p IS=121.703f M=602.211m N=998.718m
Text=+ RL=57.5MEG RS=81.8632m TT=144.27n VJ=952.957m)
Text=*** From file C:\MICROCAP12\library\MICROSEM.LBR
Text=*** 4Amp Super Fast Recovery Rectifier
Text=.MODEL UTX4120 D (BV=200 CJO=77.0247p IS=121.703f M=602.211m N=998.718m
Text=+ RL=230MEG RS=81.8632m TT=144.27n VJ=952.957m)

[InfoPage]
InfoPage=True
Warnings=True
System=True
Defines=True
Array=True
Model=True
Measure=True
MacroSubckt=True
NotUsed=True
ComponentCounts=True
VariablizePaths=False
DontShowPaths=False
SimulationLog=True

[Transient]
WinID=1
Window Placement=0,1, -1,-1, -8,-31, 0,0,633,524
Font=Height=-19,FStyle=0,Color=#0000FF,Name=Arial
WinBackGround Color=#FFFFFF
Select Color=#FF0000
Anchor Color=#000000
Select Box Color=#000080
Title=HACHEUR ordinateur 2.cir
AutoTitle=Yes
Grid Color=#808080
Grid Weight=1
Grid Pattern=Dot6
Tracker Foreground=Height=-15,FStyle=0,Color=#000000,Name=Arial
Tracker Background=#FFFF00
Baseline color=#0000FF
BaseLine Weight=1
CurveFit color=#FF0000
CurveFit Weight=2
CurveFit Pattern=Dash
Static Grids=False
PlusMark=False
MinorLog25=Off
LabelMinor=Off
DataPoints=False
Token=False
Ruler=False
XAxisGrids=True
YAxisGrids=False
MinorLogGrids=True
BaseLine=False
AlignZ=True
Align Cursors=True
TagFormatX=3
TagFormatY=3
FormulaFormat=2
EndMode=SCALE
Graph Background=#FFFFFF
Tracker Intercept=False
Tracker Mouse=True
Tracker Cursor=True
Tracker Cursor BranchInfo=False
Horizontal Cursor=False
Same Y Scales=Yes
Enable X Scaling=True
Enable Y Scaling=True
Keep X Scales The Same=True
Number of Grids X=5
Number of Grids Y=5
Cursor Select Color Primary=#C0C0C0
Cursor Select Color Secondary=#FF0000
Data Point Labels Color Fore=Height=-15,FStyle=0,Color=#000000,Name=Arial
Data Point Labels Color Back=#FFFF00
OperPoint=True
OperPointOnly=False
AutoScaleRanges=True
FixedTimeStep=False
DoPSS=False
PSS_Periods="1"
PSS_Iterations="5"
PSS_Error="1u"
PSS_ShowPlots=True
FFT_NPts="8192"
FFT_IncludeDCHarmonic=False
FFT_AutoScale_Harmonics="10"
PrinterAutoTile=No
PrinterBlackBorder=No
MonMaxShow=10
MonPageWidth=66
MonPlotWidth=21
MonExprXWidth=142
MonExprYWidth=367
MonRangeXWidth=90
MonRangeYWidth=90
AnimateWait=None
AnimateWaitTime=500
AnimatePressAfter=0
Save_For_Future=Yes
Reduce_Display=1
Reduce_Save=1
Reduce_ThrowDataOut=0
Num Out Header Left
Num Out Header Center="$MC\n$user\n$company\n$Analysis of $name\n$date $time"
Num Out Header Right
Num Out Delimiter=32
Num Out Write=True
Num Out Write Main Header=True
Num Out Write Limits=True
Num Out Write Branch Header=True
Num Out Write Models=False
Num Out Write Zero Models=True
Num Out Write Undefined Models=True
Num Out Write Operating Point=True
Num Out Write Measurement Values=True
Num Out Write Tolerance Detail=True
Num Out Write Values=True
Num Out Write Waveform Header=True
Num Out Allow Dup Y Expr=False
Num Out Low="TSTART"
Num Out High="TMAX"
Num Out Font=Height=-15,FStyle=0,Color=#000000,Name=Courier New
Num Out Window Placement=0,1, -1,-1, -1,-1, 52,52,1673,681
Num Out Format=3
Num Out HideNonSelected=False
Num Out UseActualDataPoints=False
AutoSaveWave=False
Wave Format=16E
State Variables Format=5E
Print Individual Pages=False

[Tools]
Pos=Top
SELECT=Yes
PAN=Yes
GRAPHIC=Yes
LINE=No
ELLIPSE=No
RECT=No
DIAM=No
ARC=No
PIE=No
TRIANGLE=No
STAR=No
LEFTBRK=No
RIGHTBRK=No
BOTHBRK=No
META=No
PARALLELOGRAM=No
POLYCLOS=No
POLYOPEN=No
SCALE=Yes
CURSOR=Yes
MEASUREH=Yes
MEASUREV=Yes
TAG=Yes
PTAG=Yes
TEXT=Yes
PROPERTY=Yes
START=Yes
STOP=Yes
PAUSE=Yes
RESUME=No
DATAPTS=Yes
TOKENS=Yes
RULER=Yes
PLUS=Yes
XAXIS=Yes
YAXIS=Yes
MINORLOG=Yes
LOG25=Yes
BASELINE=Yes
HORIZCUR=Yes
GOTOX=Yes
GOTOY=Yes
GOTOPERF=Yes
GOTOBRNC=Yes
CLEAR_ACCUMULATED=Yes
PDELETE_ALL_PLOTS=Yes
NEXT=Yes
NEXTIN=Yes
PEAK=Yes
VALLEY=Yes
HIGH=Yes
LOW=Yes
INFLECTN=Yes
GHIGH=Yes
GLOW=Yes
BOTTOM=Yes
TOP=Yes
WAVEFORMBUFFER=Yes
AOUTPUT=Yes
PKEY=Yes
ENXSCALE=Yes
ENYSCALE=Yes
ZOOMIN=Yes
ZOOMOUT=Yes
AUTOSCALE=Yes
RESTORESCALE=No
COLOR=Yes
FONT=Yes
STYLE=Yes
SELNEXT=No
NORMALIZE=No
NORMALIZE_MIN=No
NORMALIZE_MAX=No
ADD_TAG_LEFT=No
ADD_TAG_RIGHT=No
ADD_HORZ_TAG=No
ADD_VERT_TAG=No
ALIGN_CURSORS=No
ALIGN_CURSORSZ=No
CURSORTOCLIPBOARD=No
TRACKER_CURSOR=No
TRACKER_CURSOR_BRANCHINFO=No
TRACKER_INTERCEPT=No
TRACKER_MOUSE=No
TOFRONT=Yes
TOBACK=Yes
SPLITCIRTEXTH=No
SPLITCIRTEXTV=No
SPACE_SPLITTERS_EVENLY=No
NORMALCIR=No
LABEL_WAVEFORM=No
LABEL_DATA_POINTS=No
WFB_ADD_TO_LIMITS=No
ENVELOPE=No
SAMEYSCALES=No
KEEPXSCALESTHESAME=No
CURVEFIT=No
ADD_MARKER=No
SHOWWATCH=No
BP=No
TOGGLEMODE=No
REMOVEALLTEXT=No
AUTOSCALEX=No
LABELALLMINOR=No
ALIGNLEFT=No
ALIGNCENTER=No
ALIGNRIGHT=No
ALIGNTOP=No
ALIGNMIDDLES=No
ALIGNBOTTOM=No

[APage]
Analysis=Transient
Name="MAIN"

[AObject]
Analysis=Transient
Object=PTag
EndPoint=ArrowF
CBorder=#000080
Pos=456.7699836867863,-996332.45382585749,11272.430668841762,-995963.06068601587
Font=Height=-15,FStyle=0,Color=#000080,Name=Arial
Format=3
FormatY=3
Text="Average(PD(R1)-PG(VCOM),1,TSTART,TMAX)"

[AObject]
Analysis=Transient
Object=PTag
EndPoint=ArrowF
CBorder=#000080
Pos=358.89070146818921,1803218.9973614775,15921.696574225123,1803588.3905013192
Font=Height=-15,FStyle=0,Color=#000080,Name=Arial
Format=3
FormatY=3
Text="Average(V(TENSION_SORTIE_HACHEUR)*I(R1),1,TSTART,TMAX)"

[AObject]
Analysis=Transient
Object=PTag
EndPoint=ArrowF
CBorder=#000080
Pos=-3114600.3262642738,1846.9656992084433,-3106916.8026101142,2216.3588390501318
Font=Height=-15,FStyle=0,Color=#000080,Name=Arial
Format=3
FormatY=3
Text="RMS(I(X1.LA),1,TSTART,TMAX)"

[AObject]
Analysis=Transient
Object=PTag
EndPoint=ArrowF
CBorder=#000080
Pos=-3114600.3262642738,1846.9656992084433,-3106916.8026101142,2216.3588390501318
Font=Height=-15,FStyle=0,Color=#000080,Name=Arial
Format=3
FormatY=3
Text="RMS(I(X1.LA),1,TSTART,TMAX)"

[AObject]
Analysis=Transient
Object=PTag
EndPoint=ArrowF
CBorder=#000080
Pos=-3114600.3262642738,1846.9656992084433,-3106231.647634584,2216.3588390501318
Font=Height=-15,FStyle=0,Color=#000080,Name=Arial
Format=3
FormatY=3
Text="Average(I(X1.LA),1,TSTART,TMAX)"

[AObject]
Analysis=Transient
Object=PTag
EndPoint=ArrowF
CBorder=#000080
Pos=326.26427406199019,201451.18733509234,9380.0978792822189,201820.58047493405
Font=Height=-15,FStyle=0,Color=#000080,Name=Arial
Format=3
FormatY=3
Text="Average(V(V1)*I(V1),1,TSTART,TMAX)"

[AObject]
Analysis=Transient
Object=PTag
EndPoint=ArrowF
CBorder=#000080
Pos=-11261057389.885807,-419419.52506596304,-11261051386.623165,-419050.13192612136
Font=Height=-15,FStyle=0,Color=#000080,Name=Arial
Format=3
FormatY=3
Text="Peak_Y(I(V1)*12,1,2)"

[AObject]
Analysis=Transient
Object=PTag
EndPoint=ArrowF
CBorder=#000080
Pos=-11261057389.885807,-419419.52506596304,-11261051386.623165,-419050.13192612136
Font=Height=-15,FStyle=0,Color=#000080,Name=Arial
Format=3
FormatY=3
Text="Peak_Y(I(V1)*12,1,1)"

[AObject]
Analysis=Transient
Object=PTag
EndPoint=ArrowF
CBorder=#000080
Pos=-11261057389.885807,-745646.43799472298,-11261047993.474714,-745277.04485488124
Font=Height=-15,FStyle=0,Color=#000080,Name=Arial
Format=3
FormatY=3
Text="Width(V(SORTIE_HACHEUR),1,1,2)"

[DC]
WinID=3
Font=Height=-19,FStyle=0,Color=#0000FF,Name=Arial
WinBackGround Color=#FFFFFF
Select Color=#FF0000
Anchor Color=#000000
Select Box Color=#000080
Window Placement in Probe=0,1, -1,-1, 0,0, 0,0,633,555
Title
AutoTitle=Yes
Grid Color=#808080
Grid Weight=1
Grid Pattern=Dot6
Tracker Foreground=Height=-15,FStyle=0,Color=#000000,Name=Arial
Tracker Background=#FFFF00
Baseline color=#0000FF
BaseLine Weight=1
CurveFit color=#FF0000
CurveFit Weight=2
CurveFit Pattern=Dash
Static Grids=False
PlusMark=False
MinorLog25=Off
LabelMinor=Off
DataPoints=False
Token=False
Ruler=False
XAxisGrids=True
YAxisGrids=True
MinorLogGrids=True
BaseLine=False
AlignZ=True
Align Cursors=True
TagFormatX=3
TagFormatY=3
FormulaFormat=2
EndMode=SCALE
Graph Background=#FFFFFF
Tracker Intercept=False
Tracker Mouse=True
Tracker Cursor=True
Tracker Cursor BranchInfo=False
Horizontal Cursor=False
Same Y Scales=Yes
Enable X Scaling=True
Enable Y Scaling=True
Keep X Scales The Same=True
Number of Grids X=5
Number of Grids Y=5
Cursor Select Color Primary=#C0C0C0
Cursor Select Color Secondary=#FF0000
Data Point Labels Color Fore=Height=-15,FStyle=0,Color=#000000,Name=Arial
Data Point Labels Color Back=#FFFF00
AutoScaleRanges=True
PrinterAutoTile=No
PrinterBlackBorder=No
AnimateWait=None
AnimateWaitTime=500
AnimatePressAfter=0
Save_For_Future=No
Reduce_Display=1
Reduce_Save=1
Reduce_ThrowDataOut=0
Num Out Header Left
Num Out Header Center="$MC\n$user\n$company\n$Analysis of $name\n$date $time"
Num Out Header Right
Num Out Delimiter=32
Num Out Write=True
Num Out Write Main Header=True
Num Out Write Limits=True
Num Out Write Branch Header=True
Num Out Write Models=False
Num Out Write Zero Models=True
Num Out Write Undefined Models=True
Num Out Write Measurement Values=True
Num Out Write Tolerance Detail=True
Num Out Write Values=True
Num Out Write Waveform Header=True
Num Out Allow Dup Y Expr=False
Num Out Low="DCMIN"
Num Out High="DCMAX"
Num Out Font=Height=-15,FStyle=0,Color=#000000,Name=Courier New
Num Out Format=3
Num Out HideNonSelected=False
Num Out UseActualDataPoints=False
AutoSaveWave=False
Wave Format=16E
State Variables Format=5E
Print Individual Pages=False

[Tools]
Pos=Top
SELECT=Yes
PAN=Yes
GRAPHIC=Yes
LINE=No
ELLIPSE=No
RECT=No
DIAM=No
ARC=No
PIE=No
TRIANGLE=No
STAR=No
LEFTBRK=No
RIGHTBRK=No
BOTHBRK=No
META=No
PARALLELOGRAM=No
POLYCLOS=No
POLYOPEN=No
SCALE=Yes
CURSOR=Yes
MEASUREH=Yes
MEASUREV=Yes
TAG=Yes
PTAG=Yes
TEXT=Yes
PROPERTY=Yes
START=Yes
STOP=Yes
PAUSE=Yes
RESUME=No
DATAPTS=Yes
TOKENS=Yes
RULER=Yes
PLUS=Yes
XAXIS=Yes
YAXIS=Yes
MINORLOG=Yes
LOG25=Yes
BASELINE=Yes
HORIZCUR=Yes
GOTOX=Yes
GOTOY=Yes
GOTOPERF=Yes
GOTOBRNC=Yes
CLEAR_ACCUMULATED=Yes
PDELETE_ALL_PLOTS=Yes
NEXT=Yes
NEXTIN=Yes
PEAK=Yes
VALLEY=Yes
HIGH=Yes
LOW=Yes
INFLECTN=Yes
GHIGH=Yes
GLOW=Yes
BOTTOM=Yes
TOP=Yes
WAVEFORMBUFFER=Yes
AOUTPUT=Yes
PKEY=Yes
ENXSCALE=Yes
ENYSCALE=Yes
ZOOMIN=Yes
ZOOMOUT=Yes
AUTOSCALE=Yes
RESTORESCALE=No
COLOR=Yes
FONT=Yes
STYLE=Yes
SELNEXT=No
NORMALIZE=No
NORMALIZE_MIN=No
NORMALIZE_MAX=No
ADD_TAG_LEFT=No
ADD_TAG_RIGHT=No
ADD_HORZ_TAG=No
ADD_VERT_TAG=No
ALIGN_CURSORS=No
ALIGN_CURSORSZ=No
CURSORTOCLIPBOARD=No
TRACKER_CURSOR=No
TRACKER_CURSOR_BRANCHINFO=No
TRACKER_INTERCEPT=No
TRACKER_MOUSE=No
TOFRONT=Yes
TOBACK=Yes
SPLITCIRTEXTH=No
SPLITCIRTEXTV=No
SPACE_SPLITTERS_EVENLY=No
NORMALCIR=No
LABEL_WAVEFORM=No
LABEL_DATA_POINTS=No
WFB_ADD_TO_LIMITS=No
ENVELOPE=No
SAMEYSCALES=No
KEEPXSCALESTHESAME=No
CURVEFIT=No
ADD_MARKER=No
SHOWWATCH=No
BP=No
TOGGLEMODE=No
REMOVEALLTEXT=No
AUTOSCALEX=No
LABELALLMINOR=No
ALIGNLEFT=No
ALIGNCENTER=No
ALIGNRIGHT=No
ALIGNTOP=No
ALIGNMIDDLES=No
ALIGNBOTTOM=No

[Monte Carlo Options]
Analysis=Transient
Status=Off
Zero Tolerance=False
Eliminate Outliers=False
Distribution=Normal
Number of Runs=10
Seed=0

[Monte Carlo Options]
Analysis=DC
Status=Off
Zero Tolerance=False
Eliminate Outliers=False
Distribution=Normal
Number of Runs=10
Seed=0

[Limits]
Analysis=Transient
TMax=300300u
TStart=300000u
TStep=500n
NPts=0
Temp=27
RetraceRuns=1
StateVar=Zero
RunOption=Normal
Temperature Type=Linear
Accumulate Plots=False
IgnoreExprErrors=False

[WaveForm]
Analysis=Transient
Plt=1
AliasID=1
XExp=T
YExp=V(TENSION_CONTINUE_ENTREE_HACHEUR)
XRng=AutoAlways
YRng=90,15
Options=LINEARX,LINEARY
Range Grid Y=15
Enable=DontRun
CS=Normal
Line Color=#0000FF
Text Color=#0000FF
Rainbow=False
LWdth=3
VFmtX=3
VFmtY=3
ScaleFactorX="None"
ScaleFactorY="None"
ScaleUnitsX="Auto"
ScaleUnitsY="Auto"
SFmtX=2
SFmtY=2
NOFmtX=3E
NOFmtY=3E

[WaveForm]
Analysis=Transient
Plt=2
AliasID=3
XExp=T
YExp=V(TENSION_SORTIE_INTERRUPTEUR)
XRng=AutoAlways
YRng=AutoAlways
Options=LINEARX,LINEARY
Enable=Enable
CS=Normal
Line Color=#FF00FF
Text Color=#FF00FF
Rainbow=False
LWdth=2
VFmtX=3
VFmtY=3
ScaleFactorX="None"
ScaleFactorY="None"
ScaleUnitsX="Auto"
ScaleUnitsY="Auto"
SFmtX=2
SFmtY=2
NOFmtX=3E
NOFmtY=3E

[WaveForm]
Analysis=Transient
Plt=3
AliasID=2
XExp=T
YExp=V(TENSION_SORTIE_HACHEUR)
XRng=AutoAlways
YRng=1.402,1.4
Options=LINEARX,LINEARY
Range Grid Y=0.0004
Enable=Enable
CS=Normal
Line Color=#FF0000
Text Color=#FF0000
Rainbow=False
LWdth=3
VFmtX=3
VFmtY=3
ScaleFactorX="None"
ScaleFactorY="None"
ScaleUnitsX="Auto"
ScaleUnitsY="Auto"
SFmtX=2
SFmtY=2
NOFmtX=3E
NOFmtY=3E

[WaveForm]
Analysis=Transient
Plt=4
AliasID=11
XExp=T
YExp=V(VCOM)
XRng=AutoAlways
YRng=AutoAlways
Options=LINEARX,LINEARY
Enable=DontRun
Line Color=#FF0000
Text Color=#FF0000
Rainbow=False
VFmtX=3
VFmtY=3
ScaleFactorX="None"
ScaleFactorY="None"
ScaleUnitsX="Auto"
ScaleUnitsY="Auto"
SFmtX=2
SFmtY=2
NOFmtX=3E
NOFmtY=3E

[WaveForm]
Analysis=Transient
Plt=5
AliasID=7
XExp=T
YExp=PD(R1)
XRng=AutoAlways
YRng=72,62
Options=LINEARX,LINEARY
Range Grid Y=2
Enable=DontRun
CS=Normal
Line Color=#000000
Text Color=#000000
Rainbow=False
LWdth=3
VFmtX=3
VFmtY=3
ScaleFactorX="None"
ScaleFactorY="None"
ScaleUnitsX="Auto"
ScaleUnitsY="Auto"
SFmtX=2
SFmtY=2
NOFmtX=3E
NOFmtY=3E

[WaveForm]
Analysis=Transient
Plt=5
AliasID=4
XExp=T
YExp=PG(V1)
XRng=AutoAlways
YRng=72,62
Options=LINEARX,LINEARY
Range Grid Y=2
Enable=DontRun
CS=Normal
Line Color=#00FF00
Text Color=#00FF00
Rainbow=False
LWdth=3
VFmtX=3
VFmtY=3
ScaleFactorX="None"
ScaleFactorY="None"
ScaleUnitsX="Auto"
ScaleUnitsY="Auto"
SFmtX=2
SFmtY=2
NOFmtX=3E
NOFmtY=3E

[WaveForm]
Analysis=Transient
Plt=7
AliasID=5
XExp=T
YExp=V(V1)
XRng=AutoAlways
YRng=AutoAlways
Options=LINEARX,LINEARY
Enable=DontRun
Line Color=#000000
Text Color=#000000
Rainbow=False
VFmtX=3
VFmtY=3
ScaleFactorX="None"
ScaleFactorY="None"
ScaleUnitsX="Auto"
ScaleUnitsY="Auto"
SFmtX=2
SFmtY=2
NOFmtX=3E
NOFmtY=3E

[WaveForm]
Analysis=Transient
Plt=8
AliasID=6
XExp=T
YExp=I(V1)
XRng=AutoAlways
YRng=AutoAlways
Options=LINEARX,LINEARY
Enable=DontRun
Line Color=#0000FF
Text Color=#0000FF
Rainbow=False
VFmtX=3
VFmtY=3
ScaleFactorX="None"
ScaleFactorY="None"
ScaleUnitsX="Auto"
ScaleUnitsY="Auto"
SFmtX=2
SFmtY=2
NOFmtX=3E
NOFmtY=3E

[WaveForm]
Analysis=Transient
Plt=9
AliasID=8
XExp=T
YExp=I(L1)
XRng=AutoAlways
YRng=AutoAlways
Options=LINEARX,LINEARY
Enable=DontRun
Line Color=#008000
Text Color=#008000
Rainbow=False
VFmtX=3
VFmtY=3
ScaleFactorX="None"
ScaleFactorY="None"
ScaleUnitsX="Auto"
ScaleUnitsY="Auto"
SFmtX=2
SFmtY=2
NOFmtX=3E
NOFmtY=3E

[WaveForm]
Analysis=Transient
Plt=10
AliasID=9
XExp=T
YExp=I(D2)
XRng=AutoAlways
YRng=AutoAlways
Options=LINEARX,LINEARY
Enable=DontRun
Line Color=#FF00FF
Text Color=#FF00FF
Rainbow=False
VFmtX=3
VFmtY=3
ScaleFactorX="None"
ScaleFactorY="None"
ScaleUnitsX="Auto"
ScaleUnitsY="Auto"
SFmtX=2
SFmtY=2
NOFmtX=3E
NOFmtY=3E

[Limits]
Analysis=DC
I1Range=10,0,.5
NPts=51
Temp=27
MaxChng=5
StateVar=Zero
RunOption=Normal
Temperature Type=Linear
Accumulate Plots=False
IgnoreExprErrors=False
Sweep1 type=Auto
Sweep2 type=None
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
