Varas10/Alimentation-Photovoltaique/(commit log)

2025-03-17 ajout shéma EAGLE
    AMERICAAAAA!!!
    [alimentation.sch]
2025-03-18 Ajout excel calcule RA et RB + alpha + Eagle avec les bons composants.
    [Calcule de resistance et rapport cyclique TP3.xlsx, alimentation.brd, alimentation.sch]
2025-03-18 construction du filet
    [alimentation.brd]
2025-03-18 ajout des bananes 🍌
    [alimentation.brd, alimentation.sch]
2025-03-18 instalation des trous pour les bananes
2025-03-18 retrait des pinhead
    [alimentation.brd, alimentation.sch]
2025-03-19 redimmention de la carte
    [alimentation.brd]
2025-03-19 déplacement de fichier + importation schéma spice
    [alimentation.brd, alimentation.sch]
2025-03-20 Ajout rapport F3
    [Calcule de resistance et rapport cyclique TP3.xlsx]
2025-03-21 ajout d'une vertion sans plan de masse et modif de la taille des 🍌
    [alimentation pas plan de masse.brd, alimentation.sch]
2025-03-21 déplacement du condensateur
    [alimentation pas plan de masse.brd]
2025-03-21 Create Cahier des charges images du système.png
2025-03-21 Update Documents de MISE EN SERVICE.md
2025-03-21 Ajout de la grande conclusion
    conclusion technique et personelle
2025-03-23 suppresion fichier inutile
    [Calcule de resistance et rapport cyclique TP3.xlsx]
2025-03-26 maj du rapport pour la puissance
    je double tout le monde sur la toroute
2025-03-26 rap puissance nettoyer + corriger
    utilisation de chat gpt
2025-03-26 ajout de mon rapport perso
